mkgeiger/li-ion-battery-18v-to-14.4v-converter/LTspice/lipo_5s_protect.asc

R1: res; 22k
R2: res; 120k
R3: res; 10k
R4: res; 4700k
RL: res; 1
U1: TL431
U2: dsei60-06a
U3: dsei60-06a
U4: irf4905
Vbat: voltage; ""
Named nets: 0
.dc Vbat 15 18 0.001
.inc irf4905.spi
.inc tl431.spi
.inc dsei60-06a.spi
