mkgeiger/li-ion-battery-18v-to-14.4v-converter/Schematic/Lipo18V_to_14.4V_protect.kicad_sch

## KiCad design Schematic/Lipo18V_to_14.4V_protect.kicad_sch (2024-09-26)

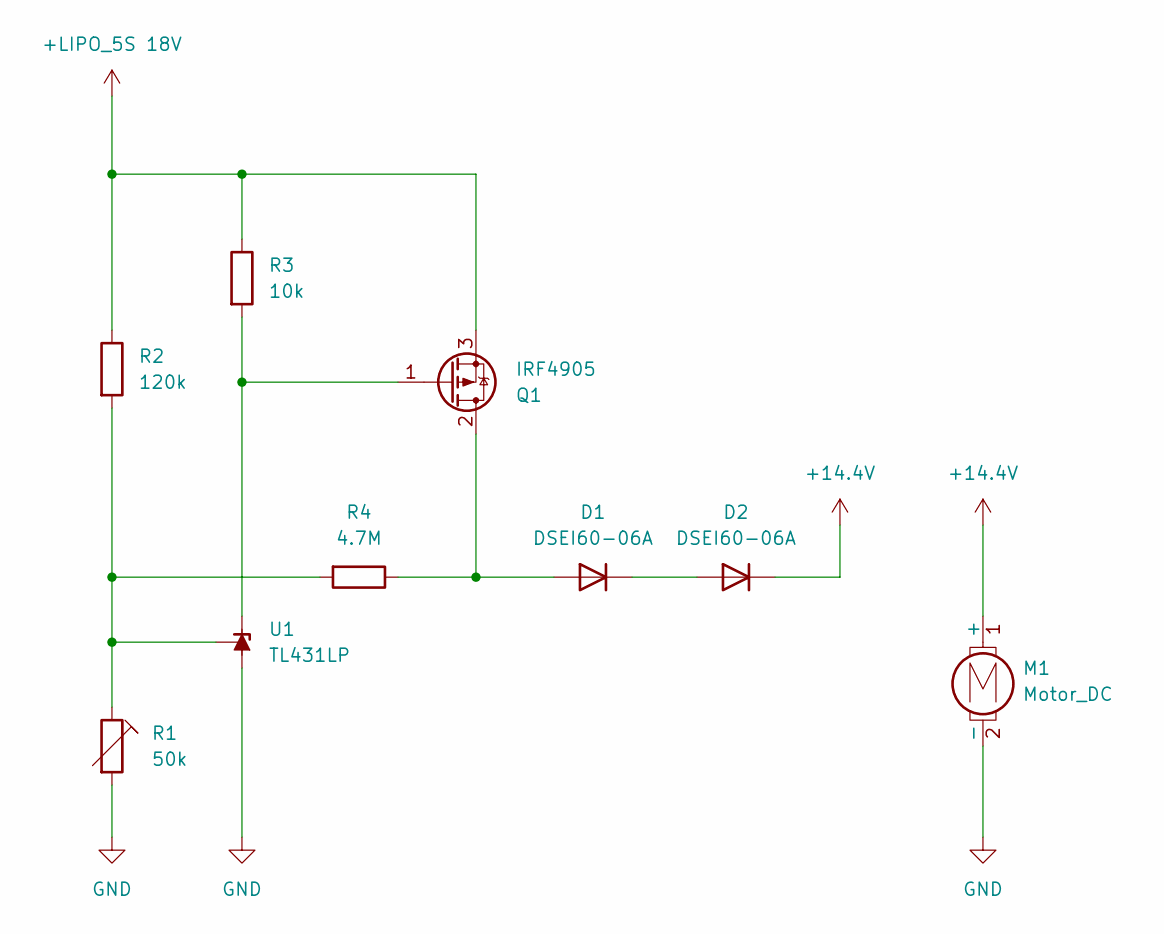
[picture p4: schematic Lipo18V_to_14.4V_protect.kicad_sch]

Parts:
D1, D2: DSEI60-06A; D_DO-41_SOD81_P10.16mm_Horizontal
M1: Motor_DC
Q1: IRF4905; TO-220-3_Vertical
R1: 50k
R2: 120k
R3: 10k
R4: 4.7M
U1: TL431LP; TO-92_Inline

Connections:
+14.4V: D2.1 (K), M1.1 (+)
+LIPO_5S 18V: Q1.3 (S), R2.1, R3.1
GND: M1.2 (-), R1.2, U1.2 (A)
unnamed: D1.1 (K), D2.2 (A)
unnamed: D1.2 (A), Q1.2 (D), R4.1
unnamed: Q1.1 (G), R3.2, U1.3 (K)
unnamed: R1.1, R2.2, R4.2, U1.1 (REF)
