mkgeiger/li-ion-battery-18v-to-14.4v-converter/(commit log)

2024-09-26 LTspice simulation files and Kicad schematic added
    [Lipo18V_to_14.4V_protect.kicad_sch]
2024-09-26 Update README.md with schematic and simulation description
